jschmidtnj/MobileWeatherStation/README.md

# MobileWeatherStation

## See the website: https://anemometer.ml/

## Pictures:

https://photos.app.goo.gl/s7rsp1NOIN0pSXKF3
https://photos.app.goo.gl/MtEDudGlJoaqBYfv1
https://photos.app.goo.gl/5Rs8EOyYQoLnrvp83
https://photos.app.goo.gl/ZVBhuRqQ1aonho1K3
https://photos.app.goo.gl/fF9p4nzz03dgmVnp1
https://photos.app.goo.gl/8xA4HH8arvOQEntG3

## Short summary:




This mobile weather station has an altimeter, pressure sensor, wind-speed anemometer, and two temperature sensors for getting real-time weather data. It is completely off-the-grid with a solar panel, and displays the data on three different mediums - an e-ink display, a website, and a local mysql database on the raspberry pi. Once the write-up is done (this project is for a design class), I will link it here with more information.

## Final Report: https://github.com/jschmidtnj/MobileWeatherStation/tree/master/docs/FinalReport

## Miscellaneous notes:

ssh pi@155.246.113.68
delete table data;
https://github.com/jamiewilson/form-to-google-sheets

https://jschmidtnj.github.io/MobileWeatherStation/

Raspberry Pi pinout: https://photos.app.goo.gl/C77Je6fZUghhErgL2

E-paper screen info: https://www.waveshare.com/wiki/2.9inch_e-Paper_Module?Amazon

e-paper library: https://github.com/ZinggJM/GxEPD

use GxGDEH029A1 library for the 2.9 inch display

another library: https://github.com/soonuse/gdew029z10_2.9inch_e-paper_b/blob/master/raspberrypi/python/epd2in9b.py

a promising library: https://github.com/soonuse/gdew029z10_2.9inch_e-paper_b/blob/master/raspberrypi/python/main.py

temperature barometer-sensor library: https://learn.sparkfun.com/tutorials/bmp180-barometric-pressure-sensor-hookup-

temperature humidity-sensor: https://create.arduino.cc/projecthub/attari/temperature-monitoring-with-dht22-arduino-15b013

https://github.com/soonuse/epd-library-python

https://github.com/adafruit/Adafruit-SSD1331-OLED-Driver-Library-for-Arduino

https://gist.github.com/TheRayTracer/dd12c498e3ecb9b8b47f

https://d2v9y0dukr6mq2.cloudfront.net/video/thumbnail/anemometer-moving-in-the-wind_bjgpy13gb__F0000.png

http://shields.io/
