jschmidtnj/MobileWeatherStation/anemometer_background.png

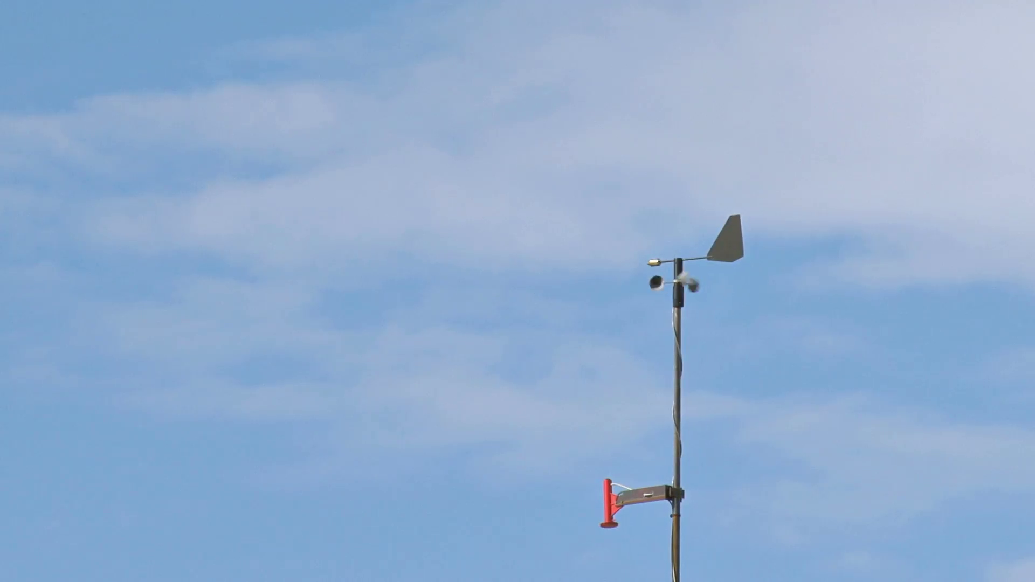
anemometer_background.png
