jschmidtnj/MobileWeatherStation/docs/assets/people-background.jpg

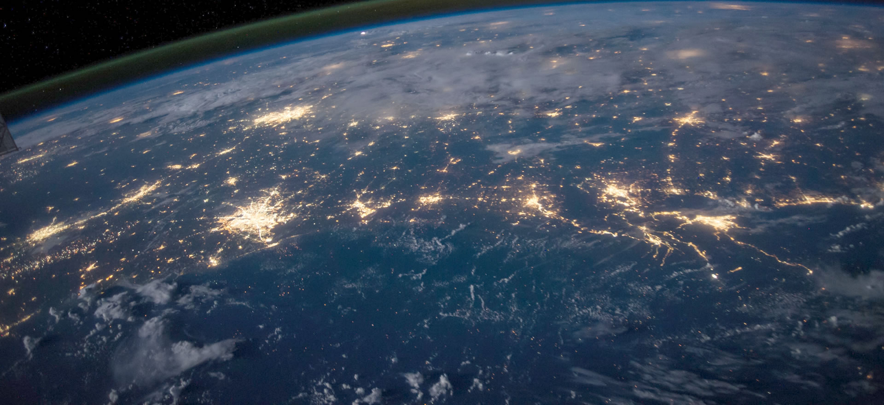
docs/assets/people-background.jpg
