jschmidtnj/MobileWeatherStation/(commit log)

2018-04-18 added data files
    [2018-04-18-13-59-17-data.csv]
2018-04-23 made x-axis date
2018-04-24 added some shell fixes
    [app.py]
2018-04-24 deleted past data files
    [2018-04-18-13-59-17-data.csv, 2018-04-18-14-08-03-data.csv, 2018-04-18-14-09-05-data.csv, 2018-04-18-14-09-26-data.csv, 2018-04-18-14-10-44-data.csv, 2018-04-18-14-13-53-data.csv, 2018-04-18-14-19-12-data.csv, 2018-04-19-13-57-25-data.csv]
2018-04-24 clearing current data
2018-04-26 added ip-addresses
    [current_data_file.csv]
